yagizkorkmaz/boost-converter/simulation/boost_open_loop.asc

C1: cap; 470�
D1: diode; SS3P5
L1: ind; 660�
M1: nmos; IRL3915
R1: res; 220
V1: voltage; 9
V2: voltage; PULSE(0 5 0 1n 1n 14.8u 20u)
Named nets: 0
.tran 0 150m 0 100n
